gdarchen/breakout/README.md

# Breakout game

At INSA Rouen, for an electronics project, we developed an Arduino game, playable thanks to a joystick. 
We then integrated the Arduino micro-controller into a specially designed and 3D printed housing.

_See the project report and presentation in the PDF files._
