gdarchen/breakout/Soutenance.pdf

# Projet d’électronique

# Console portable de casse-briques avec joystick

# Introduction

### - Objectif : créer une console portable permettant de jouer à un jeu de

casse-briques grâce à un joystick.

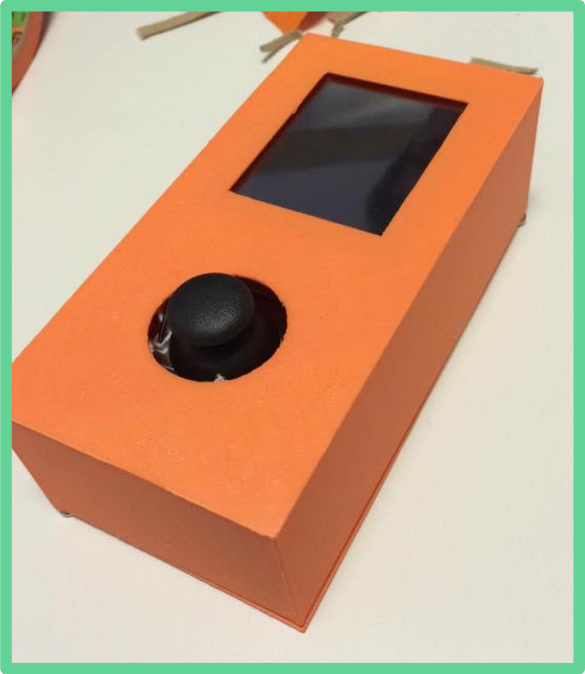
[picture p29: figure]

### - Besoins :

- Un boîtier extérieur ;
- Des composants électroniques ;
- Un code à implanter sur un micro-contrôleur.

# 1. La conception du boîtier

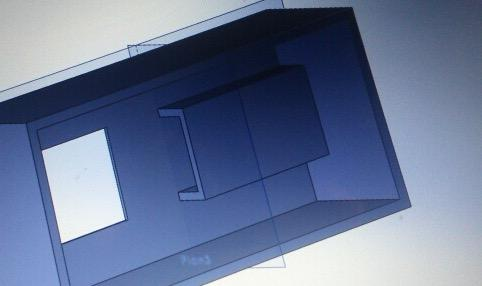
[picture p30: figure]

### - Objectifs :

- Compacité
- Respect dimensions


- Imprimable → temps + normes d’impression

### - Deux phases :

- Conception impossible à imprimer :
■ | Manque d’un “socle d’impression”
■ | dimensions incorrectes
■ | détails gênants
- Boîtier final :
■ | Optimisation de l’espace (épaisseur, largeur…)
■ | Génération de plusieurs pièces

# 2. Conception du PCB

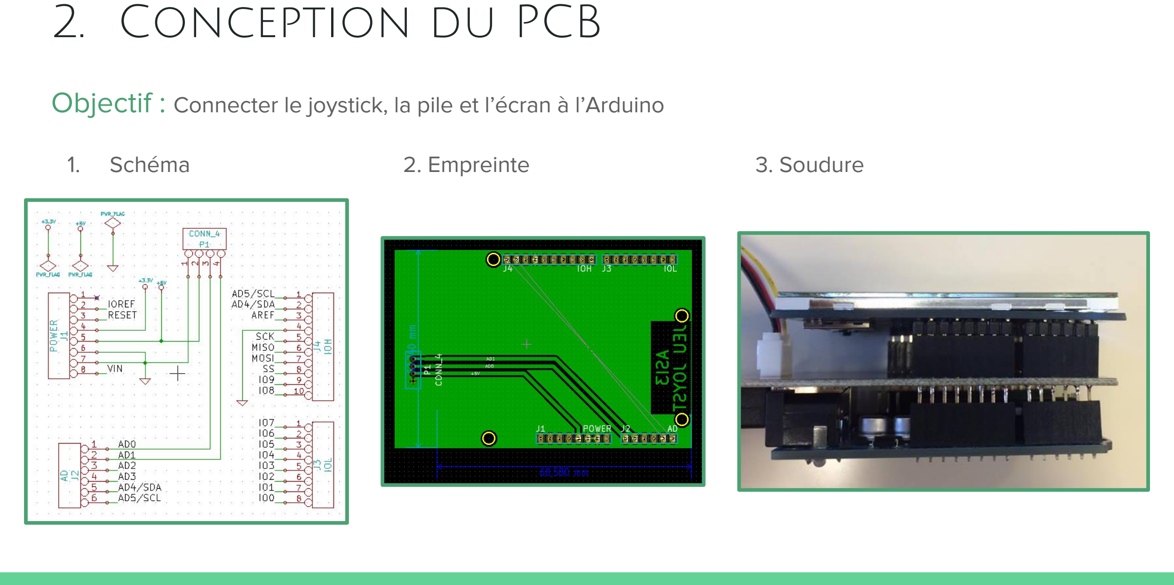
[picture p31: page 4]

Objectif : Connecter le joystick, la pile et l’écran à l’Arduino

1. | Schéma | 2. Empreinte | 3. Soudure

# 3. Programmation

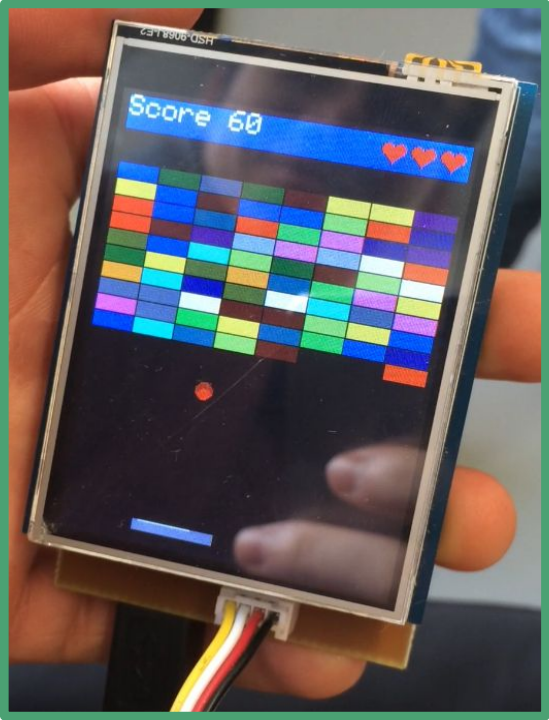
[picture p32: figure]

### - Objectifs :

- Implémentation du jeu de casse-briques
- Lien entre les différents composants

### - Deux phases :

- Joystick :
■ Lecture des valeurs sur les pins de l’Arduino
- Ecran :
■ Utilisation des librairies spécifiques à l’écran
- Casse-briques :
■ | Mouvement de la balle
■ | Gestion des collisions

# 4. Démonstration
